aalonsopuig/Melanie-I_Hexapod_Robot/Media/PICT0027.JPG

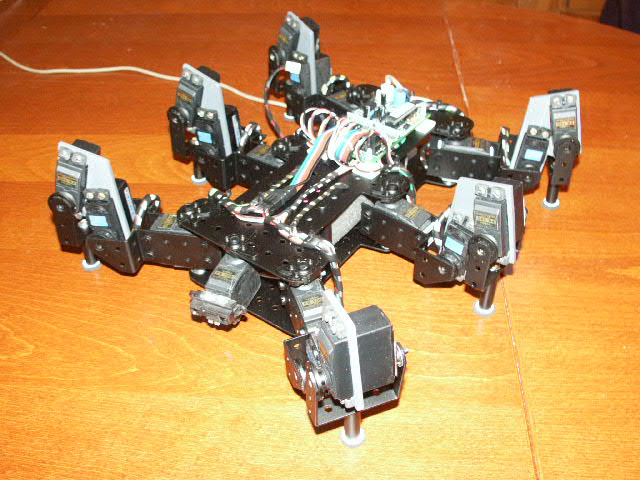
Media/PICT0027.JPG
