aalonsopuig/Melanie-I_Hexapod_Robot/Media/PICT0040.JPG

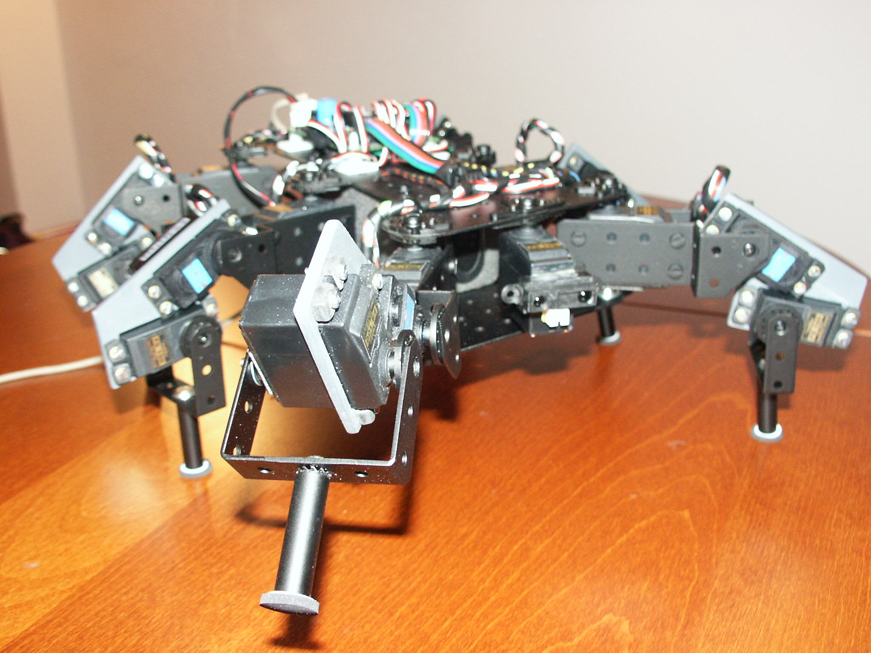
Media/PICT0040.JPG
