aalonsopuig/Melanie-I_Hexapod_Robot/Media/PICT0001.JPG

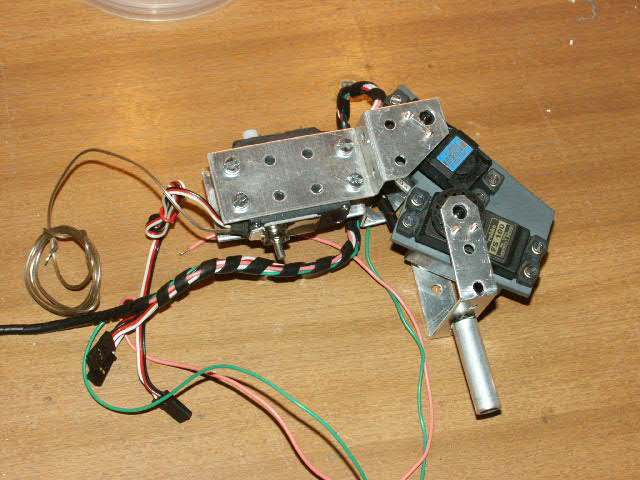
Media/PICT0001.JPG
