aalonsopuig/Melanie-I_Hexapod_Robot/Media/PICT0010.JPG

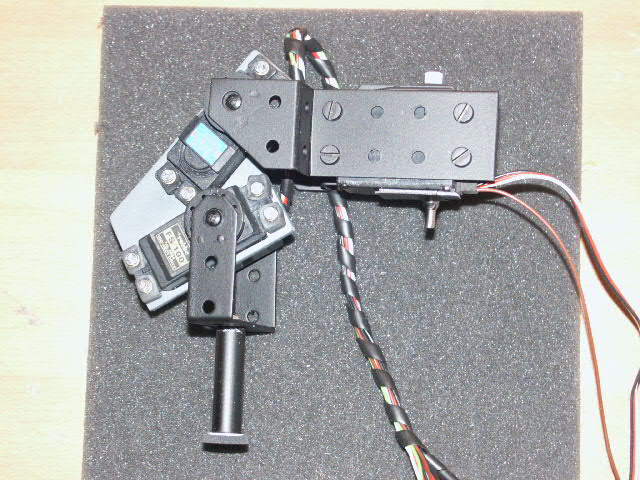
Media/PICT0010.JPG
