aalonsopuig/Melanie-I_Hexapod_Robot/Media/PICT0011.JPG

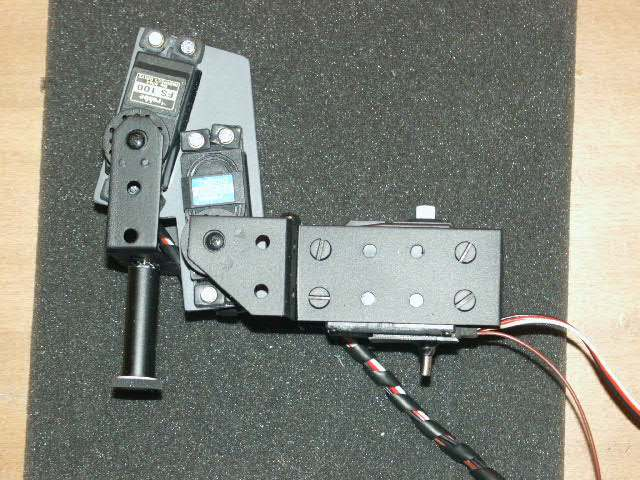
Media/PICT0011.JPG
