aalonsopuig/Melanie-I_Hexapod_Robot/Media/PICT0012.JPG

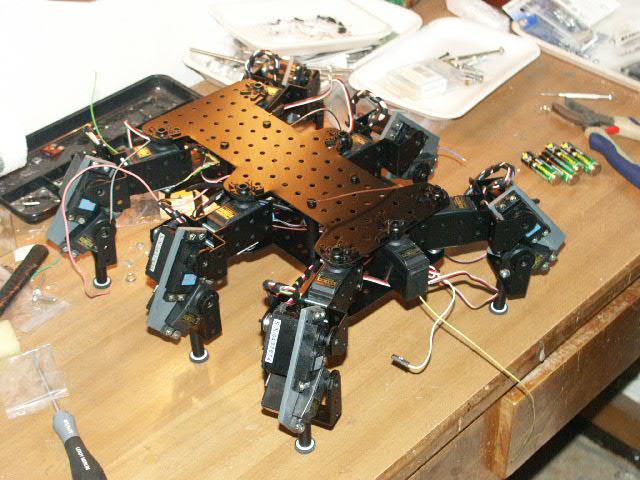
Media/PICT0012.JPG
