aalonsopuig/Melanie-I_Hexapod_Robot/Media/PICT0013.JPG

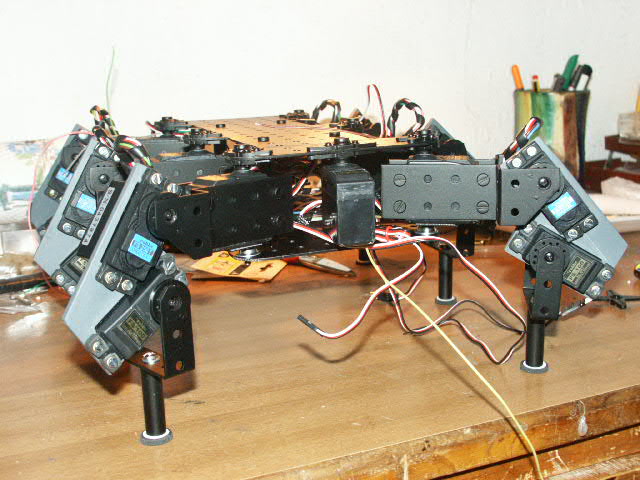
Media/PICT0013.JPG
