aalonsopuig/Melanie-I_Hexapod_Robot/Media/PICT0014.JPG

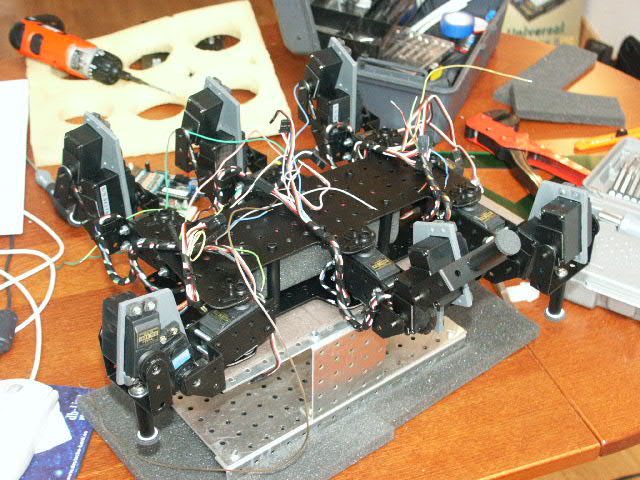
Media/PICT0014.JPG
