aalonsopuig/Melanie-I_Hexapod_Robot/Media/PICT0015.JPG

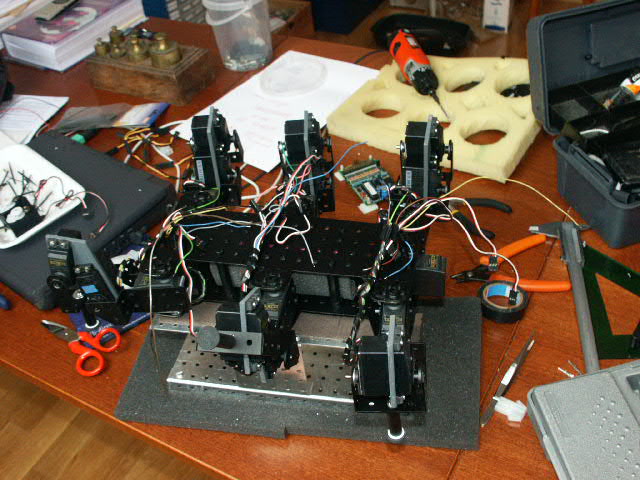
Media/PICT0015.JPG
