aalonsopuig/Melanie-I_Hexapod_Robot/Media/PICT0016.JPG

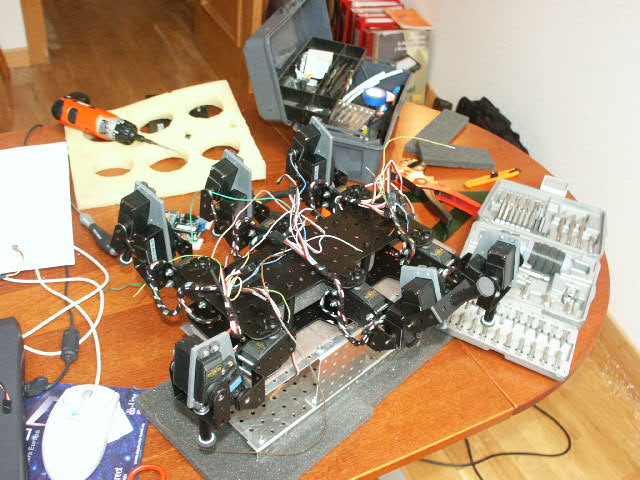
Media/PICT0016.JPG
