aalonsopuig/Melanie-I_Hexapod_Robot/Media/PICT0017.JPG

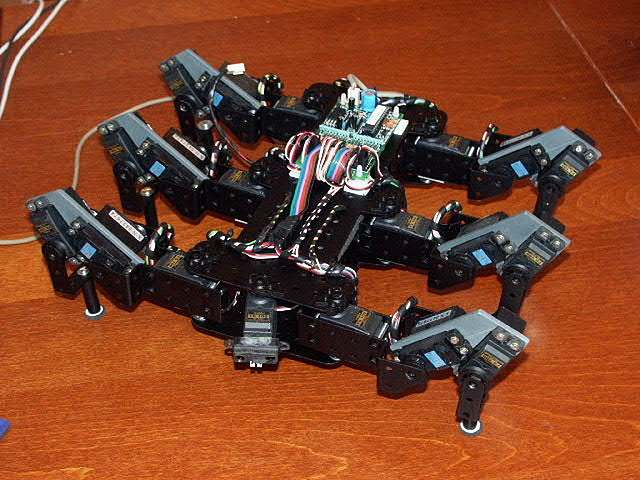
Media/PICT0017.JPG
