aalonsopuig/Melanie-I_Hexapod_Robot/Media/PICT0018.JPG

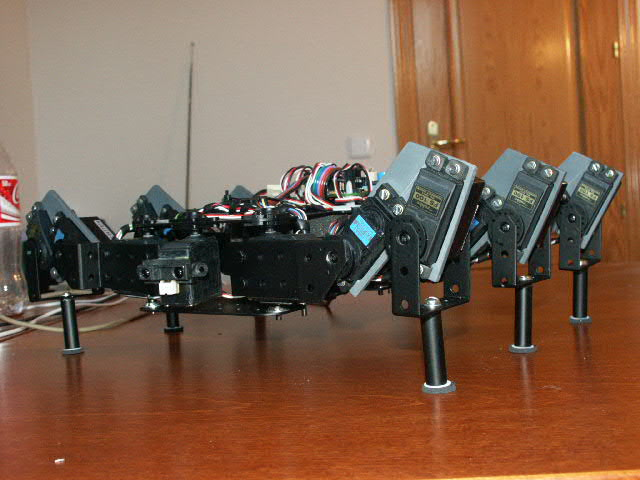
Media/PICT0018.JPG
