aalonsopuig/Melanie-I_Hexapod_Robot/Media/PICT0019.JPG

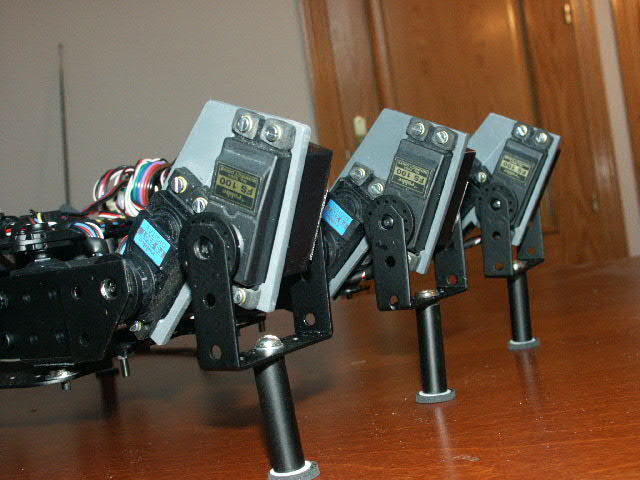
Media/PICT0019.JPG
