aalonsopuig/Melanie-I_Hexapod_Robot/Media/PICT0020.JPG

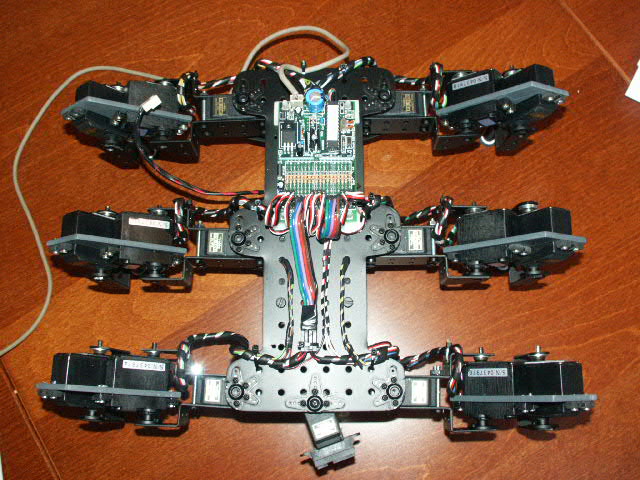
Media/PICT0020.JPG
