aalonsopuig/Melanie-I_Hexapod_Robot/Media/PICT0021.JPG

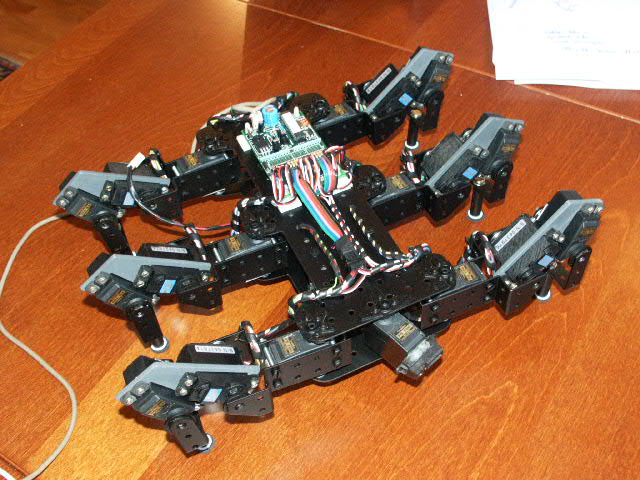
Media/PICT0021.JPG
