aalonsopuig/Melanie-I_Hexapod_Robot/Media/PICT0022.JPG

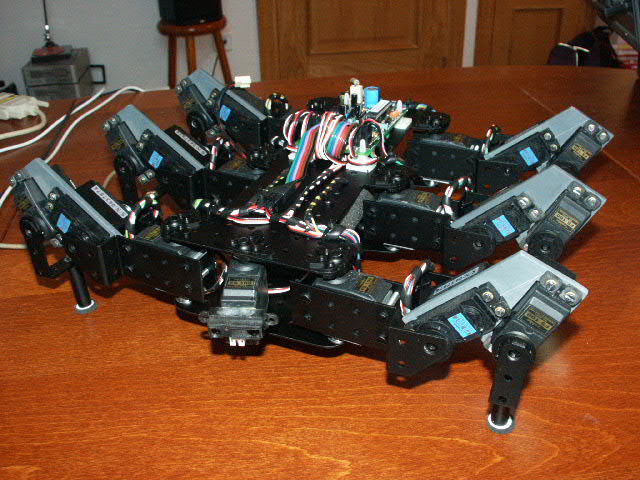
Media/PICT0022.JPG
