aalonsopuig/Melanie-I_Hexapod_Robot/Media/PICT0023.JPG

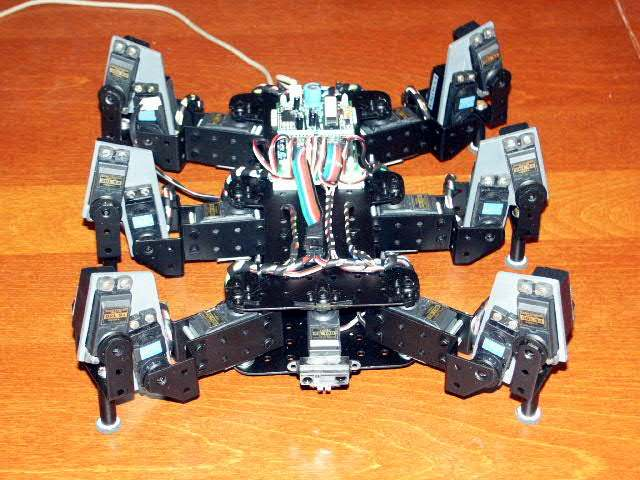
Media/PICT0023.JPG
