aalonsopuig/Melanie-I_Hexapod_Robot/Media/PICT0024.JPG

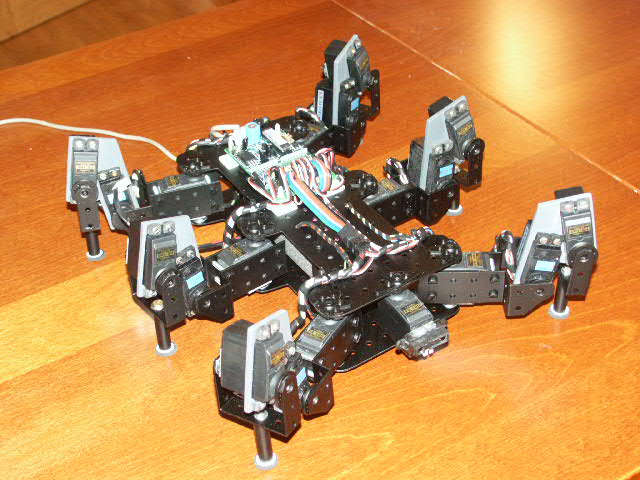
Media/PICT0024.JPG
