aalonsopuig/Melanie-I_Hexapod_Robot/Media/PICT0025.JPG

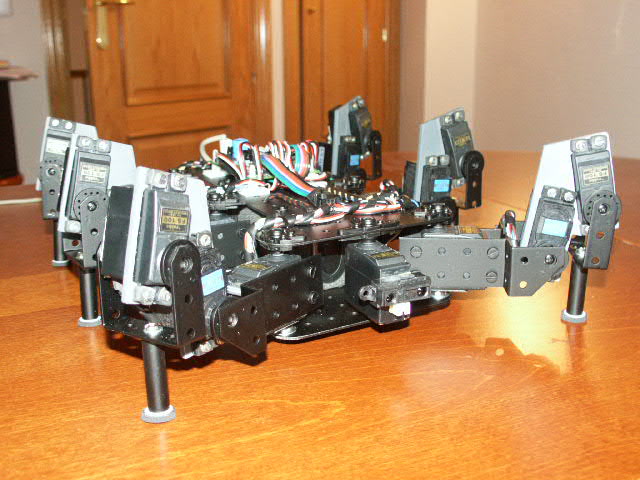
Media/PICT0025.JPG
