aalonsopuig/Melanie-I_Hexapod_Robot/Media/PICT0026.JPG

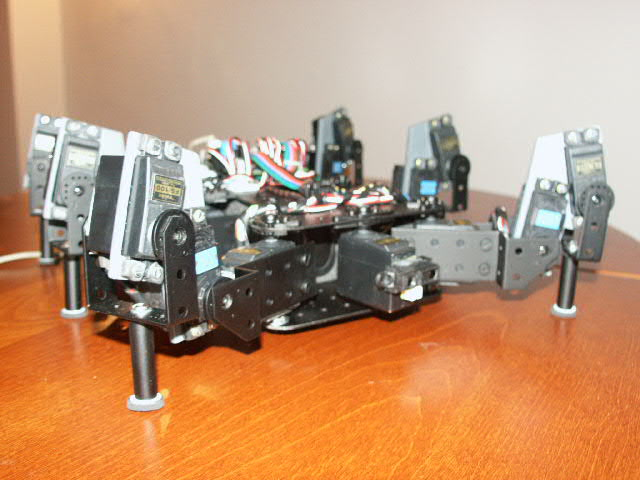
Media/PICT0026.JPG
