aalonsopuig/Melanie-I_Hexapod_Robot/Media/PICT0028.JPG

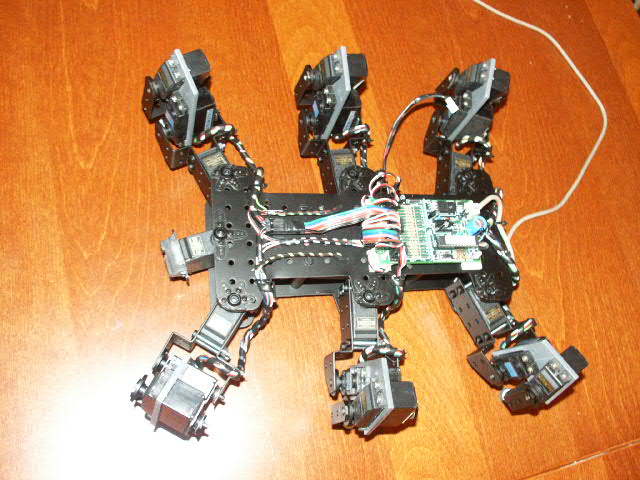
Media/PICT0028.JPG
