aalonsopuig/Melanie-I_Hexapod_Robot/Media/PICT0029.JPG

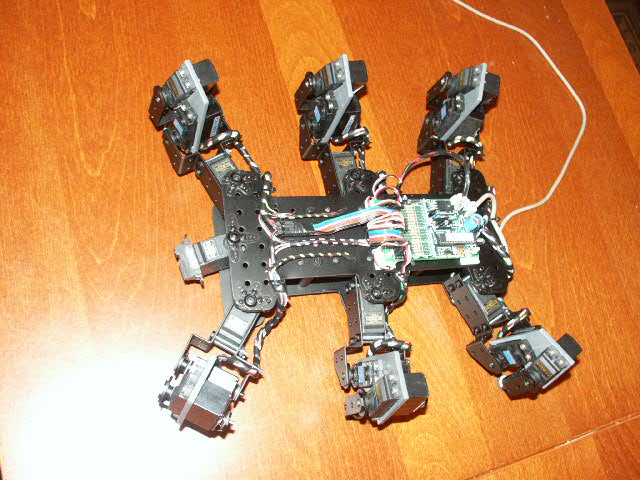
Media/PICT0029.JPG
