aalonsopuig/Melanie-I_Hexapod_Robot/Media/PICT0030.JPG

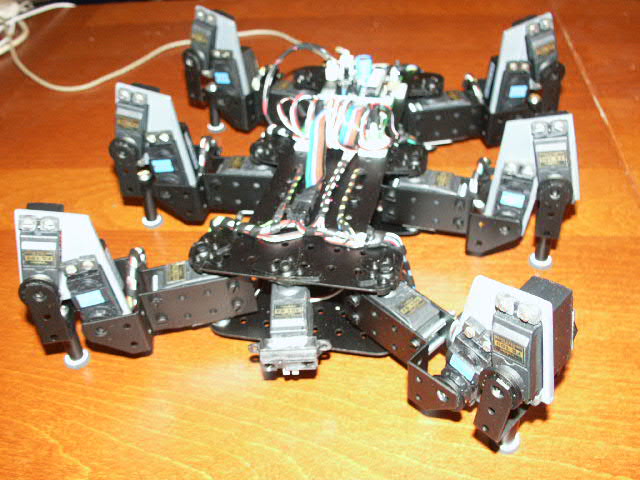
Media/PICT0030.JPG
