aalonsopuig/Melanie-I_Hexapod_Robot/Media/PICT0031.JPG

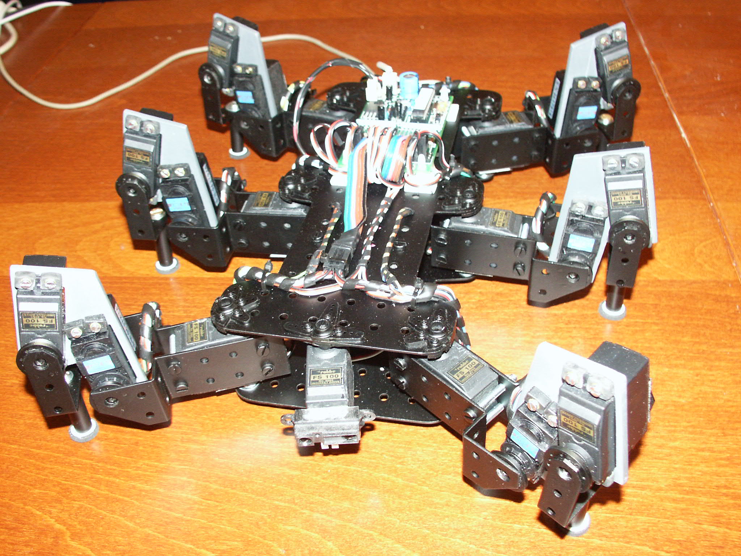
Media/PICT0031.JPG
