aalonsopuig/Melanie-I_Hexapod_Robot/Media/PICT0032.JPG

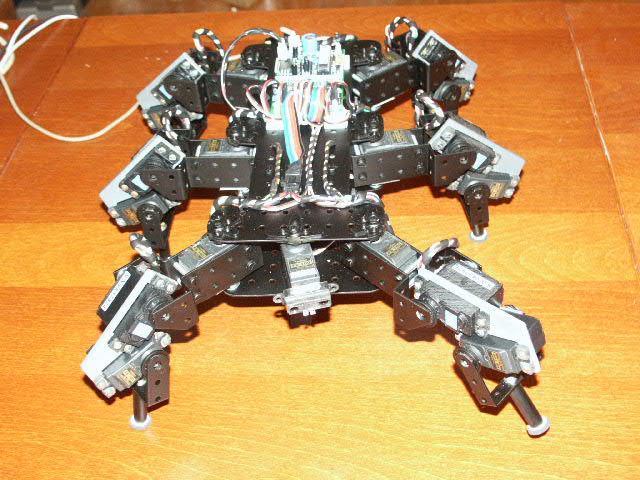
Media/PICT0032.JPG
