aalonsopuig/Melanie-I_Hexapod_Robot/Media/PICT0033.JPG

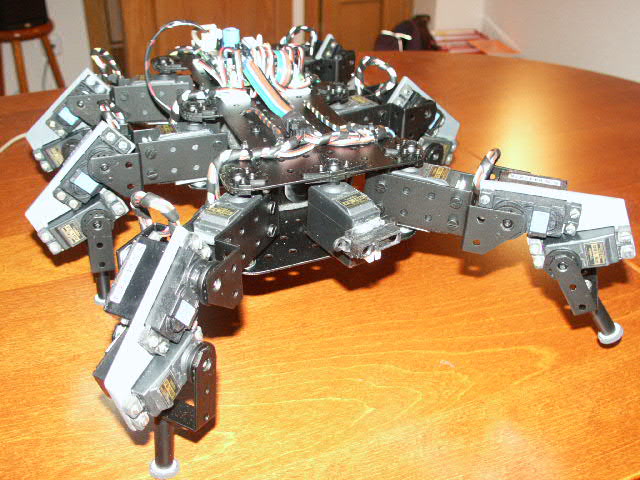
Media/PICT0033.JPG
