aalonsopuig/Melanie-I_Hexapod_Robot/Media/PICT0034.JPG

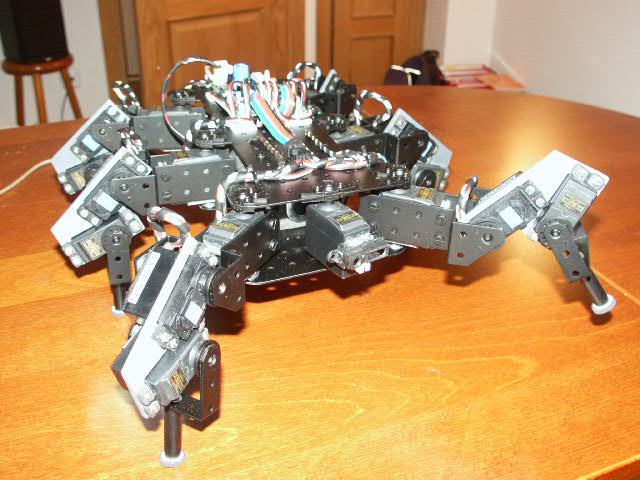
Media/PICT0034.JPG
