aalonsopuig/Melanie-I_Hexapod_Robot/Media/PICT0035.JPG

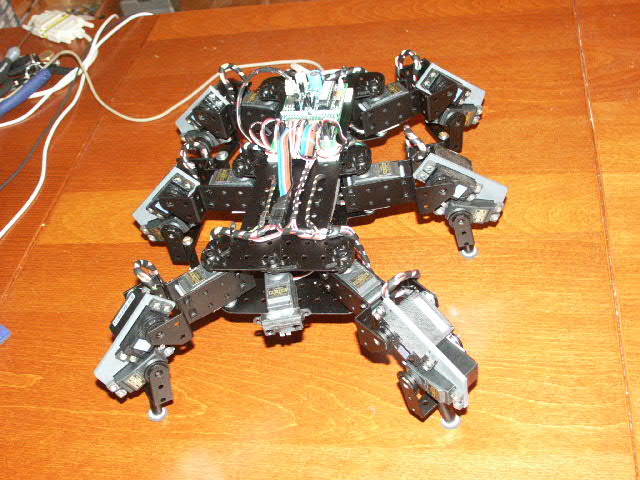
Media/PICT0035.JPG
