aalonsopuig/Melanie-I_Hexapod_Robot/Media/PICT0036.JPG

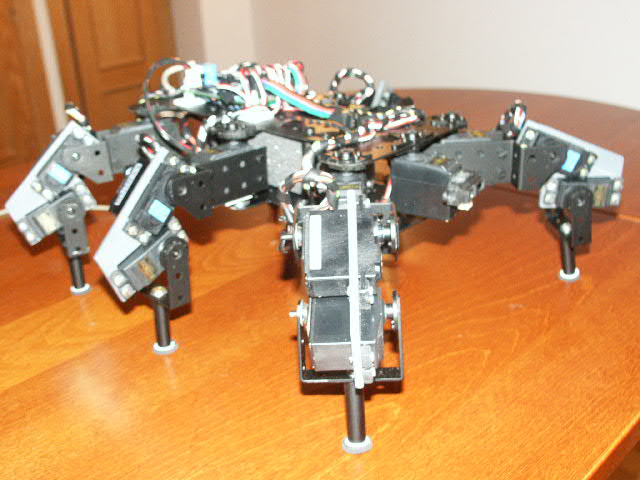
Media/PICT0036.JPG
