aalonsopuig/Melanie-I_Hexapod_Robot/Media/PICT0037.JPG

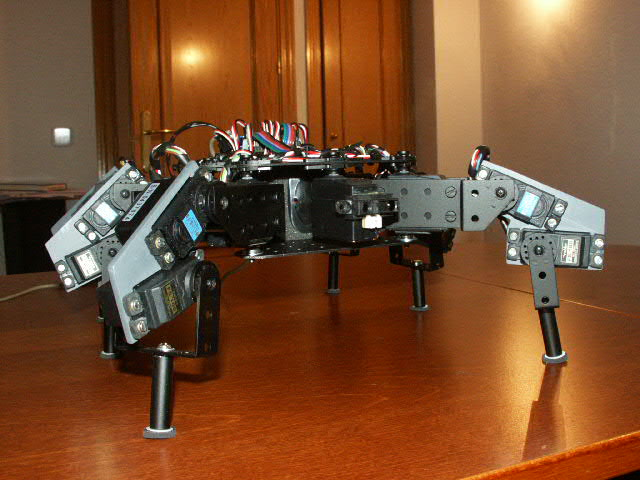
Media/PICT0037.JPG
