aalonsopuig/Melanie-I_Hexapod_Robot/Media/PICT0038.JPG

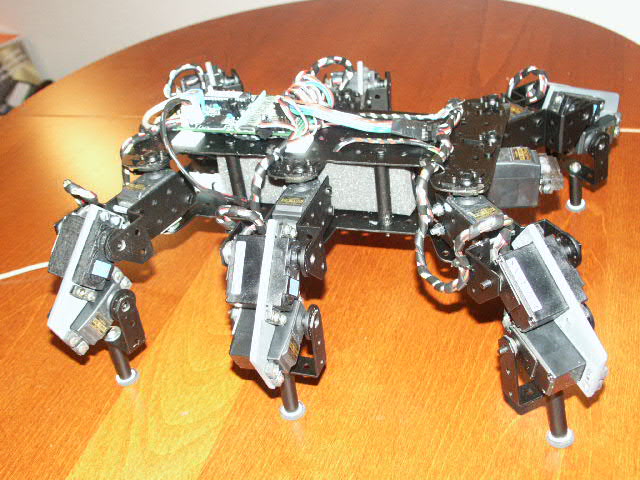
Media/PICT0038.JPG
