aalonsopuig/Melanie-I_Hexapod_Robot/Media/PICT0039.JPG

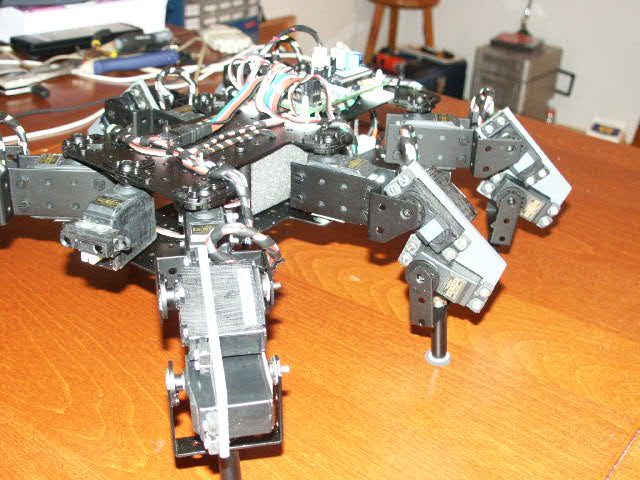
Media/PICT0039.JPG
