aalonsopuig/Melanie-I_Hexapod_Robot/Media/PICT0041.JPG

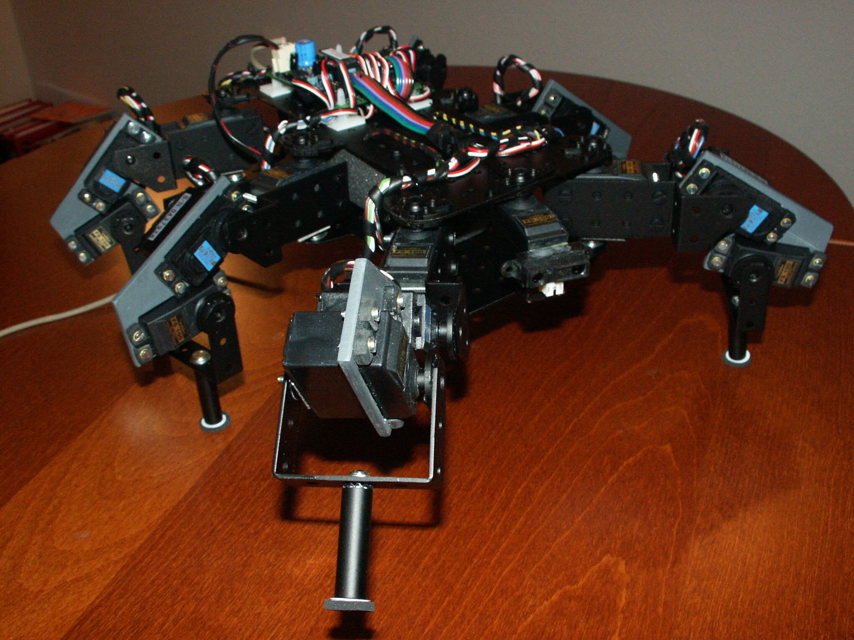
Media/PICT0041.JPG
