aalonsopuig/Melanie-I_Hexapod_Robot/Media/PICT0042.JPG

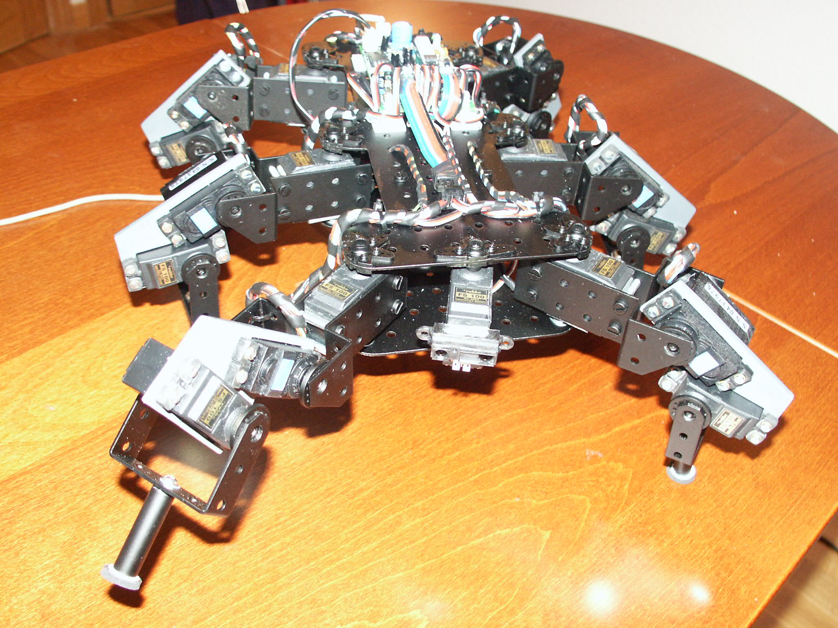
Media/PICT0042.JPG
