aalonsopuig/Melanie-I_Hexapod_Robot/Media/PICT0043.JPG

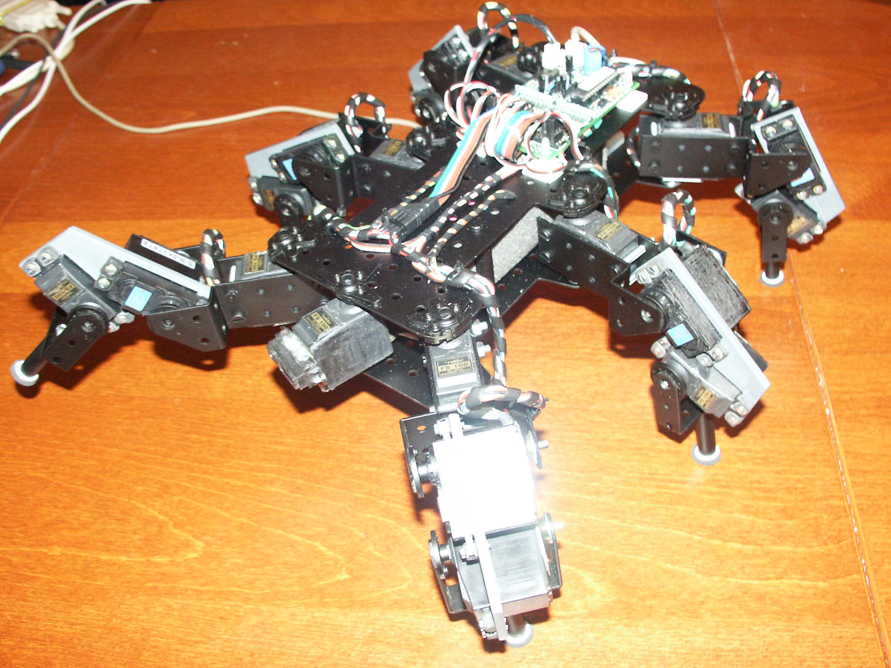
Media/PICT0043.JPG
