aalonsopuig/Melanie-I_Hexapod_Robot/Media/PICT0044.JPG

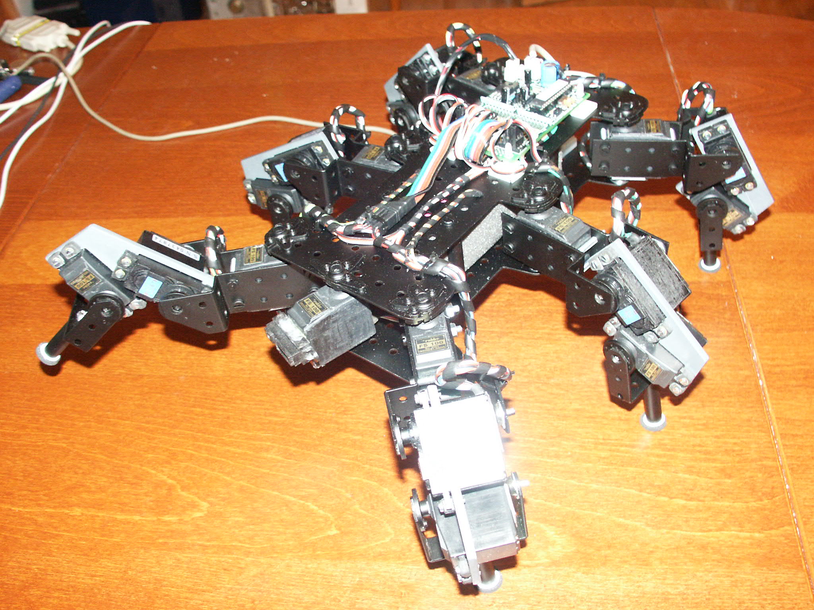
Media/PICT0044.JPG
