aalonsopuig/Melanie-I_Hexapod_Robot/Melanie-I_Program/resource.h

//{{NO_DEPENDENCIES}}
// Microsoft Developer Studio generated include file.
// Used by Melanie.rc
//
#define IDD_MELANIE_DIALOG              102
#define IDR_MAINFRAME                   128
#define IDC_AD03                        1000
#define IDC_AD                          1004
#define IDC_BUTTON1                     1006
#define IDC_SLIDERSERVO01               1007
#define IDC_SLIDERSERVO02               1008
#define IDC_SLIDERSERVO03               1009
#define IDC_SLIDERSERVO04               1010
#define IDC_SLIDERSERVO05               1011
#define IDC_SLIDERSERVO06               1012
#define IDC_SLIDERSERVO07               1013
#define IDC_SLIDERSERVO08               1014
#define IDC_SLIDERSERVO09               1015
#define IDC_SLIDERSERVO11               1016
#define IDC_SLIDERSERVO12               1017
#define IDC_SLIDERSERVO13               1018
#define IDC_SLIDERSERVO14               1019
#define IDC_SLIDERSERVO15               1020
#define IDC_SLIDERSERVO16               1021
#define IDC_SLIDERSERVO17               1022
#define IDC_SLIDERSERVO18               1023
#define IDC_SLIDERSERVO19               1024
#define IDC_SLIDERSERVO10               1025
#define IDC_POS07                       1026
#define IDC_POS08                       1027
#define IDC_POS09                       1028
#define IDC_POS17                       1029
#define IDC_POS18                       1030
#define IDC_POS19                       1031
#define IDC_POS16                       1032
#define IDC_POS15                       1033
#define IDC_POS14                       1034
#define IDC_POS06                       1035
#define IDC_POS05                       1036
#define IDC_POS04                       1037
#define IDC_POS11                       1038
#define IDC_POS12                       1039
#define IDC_POS13                       1040
#define IDC_POS01                       1041
#define IDC_POS02                       1042
#define IDC_POS03                       1043
#define IDC_POS10                       1044
#define IDC_AD02                        1045
#define IDC_AD01                        1046
#define IDC_AD06                        1047
#define IDC_AD05                        1048
#define IDC_AD04                        1049
#define IDC_AD09                        1050
#define IDC_AD08                        1051
#define IDC_AD07                        1052
#define IDC_AD13                        1053
#define IDC_AD12                        1054
#define IDC_AD11                        1055
#define IDC_AD16                        1056
#define IDC_AD15                        1057
#define IDC_AD14                        1058
#define IDC_AD19                        1059
#define IDC_AD18                        1060
#define IDC_AD17                        1061
#define IDC_SAVESEQ                     1062
#define IDC_SAVEPOS                     1063
#define IDC_PAUSE                       1064
#define IDC_TOPBACK                     1065
#define IDC_ALLBACK                     1066
#define IDC_STEPBACK                    1067
#define IDC_STEPFORWARD                 1068
#define IDC_ALLFORWARD                  1069
#define IDC_TOPFORWARD                  1070
#define IDC_CLEARSEQ                    1071
#define IDC_LOADSEQ                     1072
#define IDC_LOADOVERSEQ                 1073
#define IDC_SAVEINVSEQ                  1074
#define IDC_SEQNAME                     1075
#define IDC_PRESET1                     1076
#define IDC_SWITCH                      1077
#define IDC_PRESET2                     1081
#define IDC_PRESET3                     1082
#define IDC_PRESET4                     1083
#define IDC_PRESET5                     1084
#define IDC_PRESET6                     1085
#define IDC_PRESET7                     1086
#define IDC_PRESET8                     1087
#define IDC_PRESET9                     1088
#define IDC_PRESET10                    1089
#define IDC_PRESET11                    1090
#define IDC_PRESET12                    1091
#define IDC_PRESET13                    1092
#define IDC_PRESETSET1                  1093
#define IDC_PRESETSET2                  1094
#define IDC_PRESETSET3                  1095
#define IDC_PRESETSET4                  1096

// Next default values for new objects
// 
#ifdef APSTUDIO_INVOKED
#ifndef APSTUDIO_READONLY_SYMBOLS
#define _APS_NEXT_RESOURCE_VALUE        130
#define _APS_NEXT_COMMAND_VALUE         32771
#define _APS_NEXT_CONTROL_VALUE         1079
#define _APS_NEXT_SYMED_VALUE           101
#endif
#endif
